Bouni/smart-meter-interface/README.md

# Smart Meter Interface

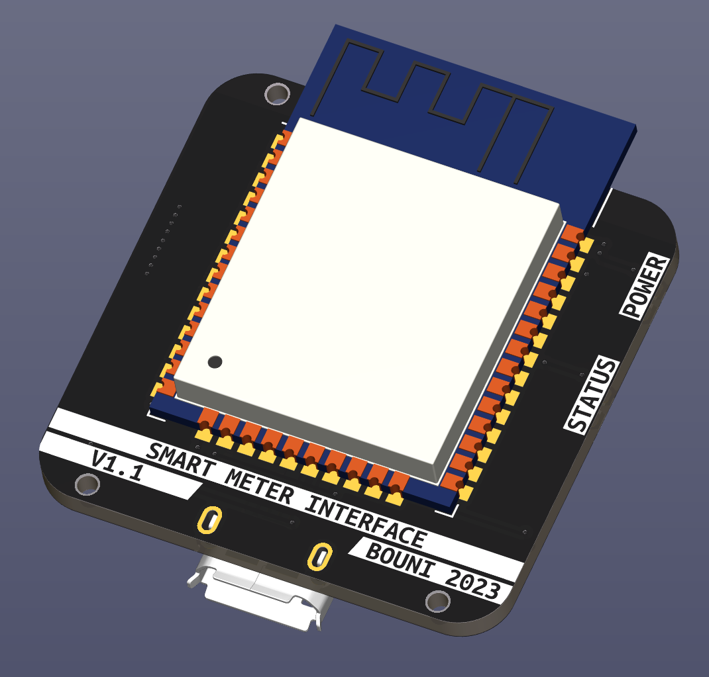
[picture p1: ISO-TOP.png]


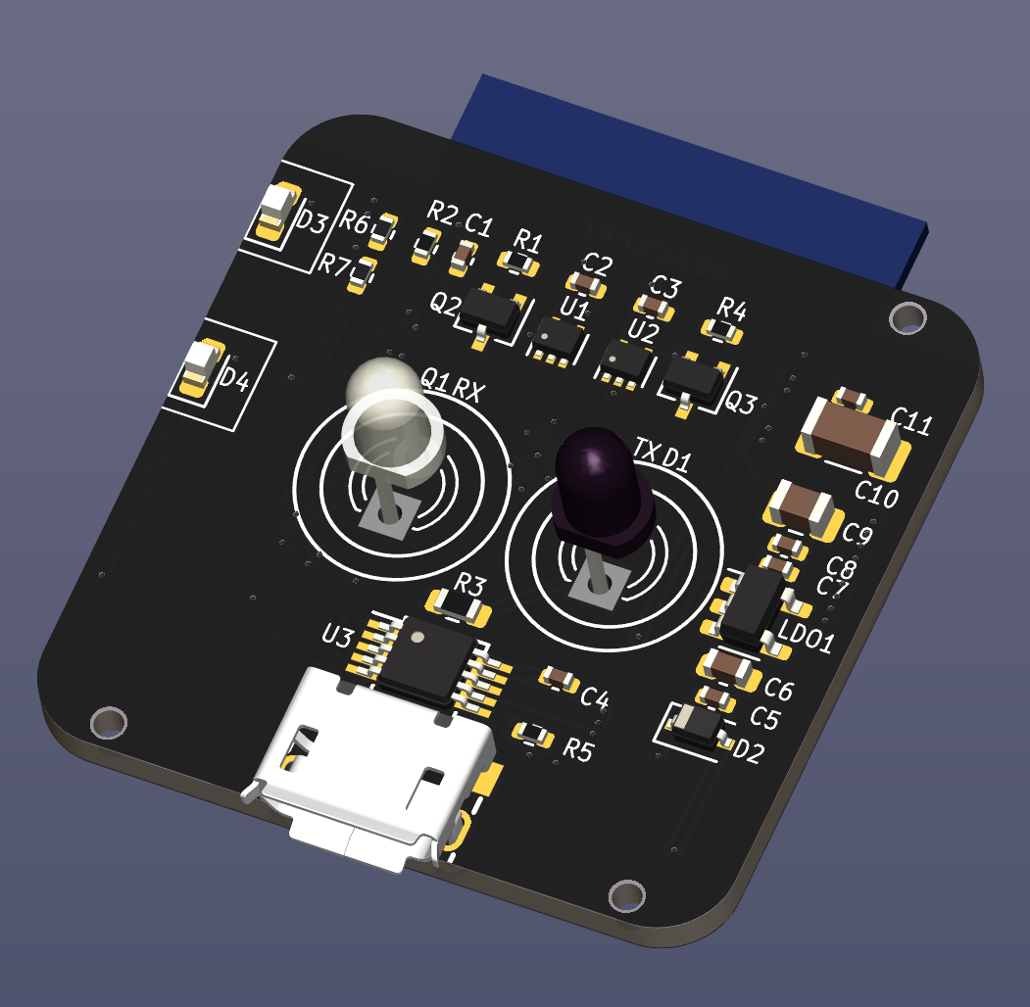
[picture p2: ISO-BOTTOM.png]
