Bouni/smart-meter-interface/hardware/smart-meter-interface.step

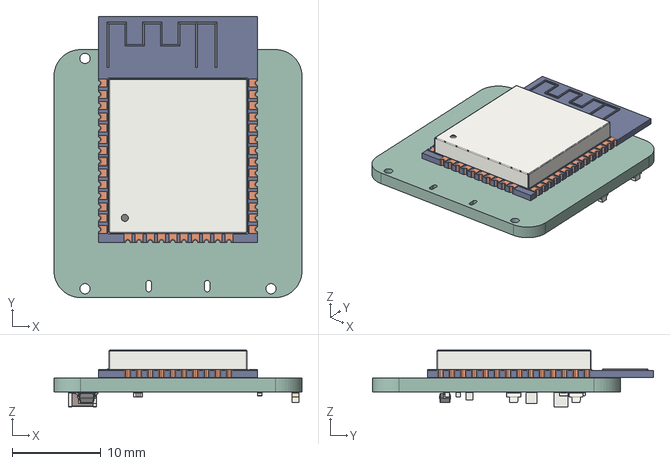
[picture p3: CAD file, 2023-10-18]
hardware/smart-meter-interface.step
28.0 x 31.7 x 6.40 mm
smart-meter-interface_PCB
