Bouni/smart-meter-interface/(commit log)

2020-10-07 Alpha stage prototype
    [D-SUN_dcdc_step_down_SIMPLE.step, ehz-adapter-v2.kicad_pcb, ehz-adapter-v2.kicad_sch, ehz-adapter-v2.step]
2020-10-08 moved mounting hooles
    [ehz-adapter-v2-B_Cu.gbr, ehz-adapter-v2-B_Mask.gbr, ehz-adapter-v2-B_SilkS.gbr, ehz-adapter-v2-Edge_Cuts.gbr, ehz-adapter-v2-F_Cu.gbr, ehz-adapter-v2-F_Mask.gbr, ehz-adapter-v2-F_SilkS.gbr, ehz-adapter-v2-NPTH.drl]
2021-02-18 fixed major layout fuckup, added MH-ET-LIVE-minikit footprint and symbol
    [ehz-adapter-v2.kicad_pcb, ehz-adapter-v2.kicad_sch]
2021-02-18 no longer track kicad_prl file
2021-02-19 fixed wrong comperator footprint, added alternative power pads
    [ehz-adapter-v2.kicad_pcb, ehz-adapter-v2.kicad_sch]
2021-02-19 replaced custom power connector pads
    [ehz-adapter-v2.kicad_pcb, ehz-adapter-v2.kicad_sch]
2021-02-19 removed useless pictures and greber files
    [ehz-adapter-v2-B_Cu.gbr, ehz-adapter-v2-B_Mask.gbr, ehz-adapter-v2-B_SilkS.gbr, ehz-adapter-v2-Edge_Cuts.gbr, ehz-adapter-v2-F_Cu.gbr, ehz-adapter-v2-F_Mask.gbr, ehz-adapter-v2-F_SilkS.gbr, ehz-adapter-v2-NPTH.drl]
2021-02-21 last minor fixes before ordering at JLCPCB
    [ehz-adapter-v2.kicad_pcb, ehz-adapter-v2.kicad_sch]
2021-12-13 Replaced D-SUN with custom Buck converter
    [ehz-adapter-v2.kicad_pcb, ehz-adapter-v2.kicad_sch]
2021-12-21 added custom buck converter
    [D-SUN_dcdc_step_down_SIMPLE.step, ehz-adapter-v2.kicad_pcb, ehz-adapter-v2.kicad_sch, ehz-adapter-v2.step]
2022-09-30 current state, works, no idea what changed
    [ehz-adapter-v2.kicad_pcb, ehz-adapter-v2.kicad_sch, ehz-adapter-v2.step, ehz-adapter-v3.kicad_pcb, ehz-adapter-v3.kicad_sch, ehz-adapter-v3.step]
2022-10-24 Many changes to use ESP32 WROOM
    [ehz-adapter-v3.kicad_pcb, ehz-adapter-v3.kicad_sch]
2022-10-31 almost finished refactor
    [ehz-adapter-v2.step, ehz-adapter-v3.kicad_pcb, ehz-adapter-v3.kicad_sch, ehz-adapter-v3.step, smart-meter-interface.kicad_pcb, smart-meter-interface.kicad_sch]
2022-10-31 replaced .wrl with .step for all possible 3D models
    [smart-meter-interface.kicad_pcb]
2022-11-04 Replaced USB micro connector 3d Model with Step file
    [smart-meter-interface.kicad_pcb]
2022-11-23 Refactor to use Comperator instead of Schmitt Trigger
    [smart-meter-interface.kicad_pcb, smart-meter-interface.kicad_sch]
2022-11-24 Final adjustments, next prototypes are ordered
    [smart-meter-interface.kicad_pcb, smart-meter-interface.kicad_sch]
2022-12-30 Major cleanup, hopefully working prototype orderd
    [smart-meter-interface.kicad_pcb, smart-meter-interface.kicad_sch]
2022-12-30 Fixed last issues
    [smart-meter-interface.kicad_pcb]
2023-01-06 Fixed wrong LCSC number of R1
    [smart-meter-interface.kicad_sch]
2023-01-12 cleanup 3d model paths
    [smart-meter-interface.kicad_pcb]
2023-01-12 moved kicad design files into subfolder
    [smart-meter-interface.kicad_pcb, smart-meter-interface.kicad_sch]
2023-01-14 fixed disconnects caused by publik key sensor
2023-01-16 Minor cleanups for V1.1
    [smart-meter-interface.kicad_pcb, smart-meter-interface.kicad_sch]
2023-10-03 Don't know what changed, something minor for sure
    [smart-meter-interface.kicad_pcb, smart-meter-interface.kicad_sch]
2023-10-05 completely refactored to CH340X and Volkszähler IR circuit
    [smart-meter-interface.kicad_pcb, smart-meter-interface.kicad_sch]
2023-10-05 shrinked pcb further to 28x28mm
    [smart-meter-interface.kicad_pcb]
2023-10-06 Minor improvements
    [smart-meter-interface.kicad_pcb]
2023-10-06 Streamlined annotations
    [smart-meter-interface.kicad_pcb, smart-meter-interface.kicad_sch]
2023-10-18 Step generiert
    [smart-meter-interface.kicad_pcb, smart-meter-interface.step]
